Sphinkie/Arditime/README.md

# Arditime

Arduino steampunk timer

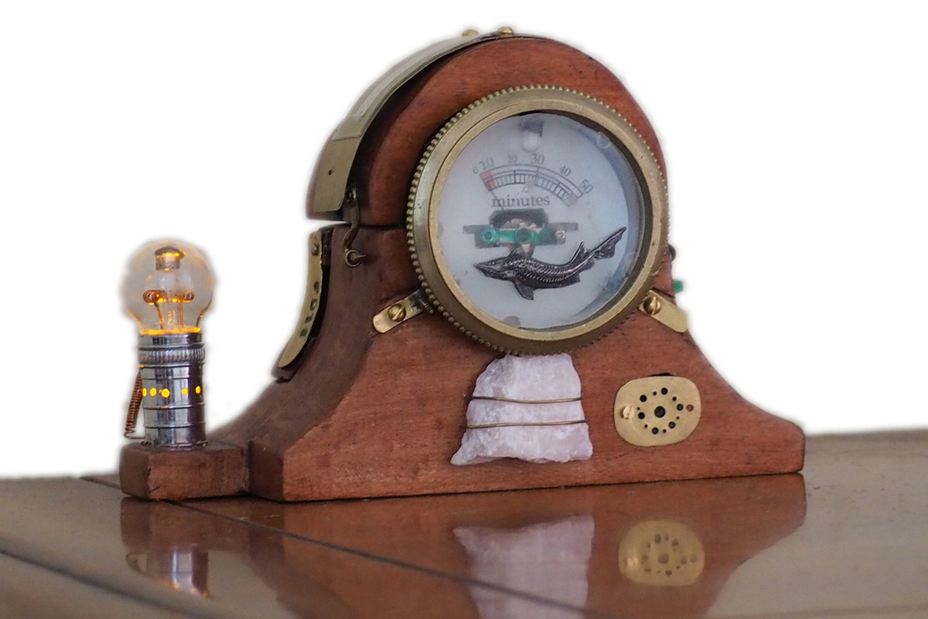
[picture p1: docs/images/arditime-1.JPG]
Arditime


## A tactile timer

Pass your finger along the top of the clock: the Arditime machine will wake up and indicate the choosen duration of the timeout on the dial (in minutes).  

Then, two minutes before the timer expires, the stone will start to glow red.  And when the timer expires, you will hear the sound of a gong.  

(During all the duration of the timer, the old amber lamp will light slowly.)  

## Credits

* Arduino **speaker_pcm** library by Michael Smith, for playing 8-bit PCM audio on pin 11 using pulse-width modulation (PWM).
* Windows **[WaveToCode](https://www.softpedia.com/get/Multimedia/Audio/Other-AUDIO-Tools/WAVToCode.shtml)** application by JCS, which convert WAV audio files into C code for inclusion in embedded systems projects. 
* **[KiCAD](http://kicad-pcb.org/)** for electronic design 
* **[VeeCAD](https://veecad.com/)** for PCB design on veroboards
