Sphinkie/Arditime/sounds/WAV/readme.md

## Wav files converted with Audacity.

to convert:
- **Mono**
- **8 kHz** : Status bar   -> "Projet à 8000Hz"
- **8-bits**: Export audio -> other uncompressed format  -> options: "WAV (Microsoft)" & "Unsigned 8 bit PCM"
