Sphinkie/Arditime/docs/pages/electronique.md

## Réalisation électronique

### Schéma

Le schéma (relativement simple) a été fait avec **[Fritzing](https://fritzing.org/)** Fritzing.

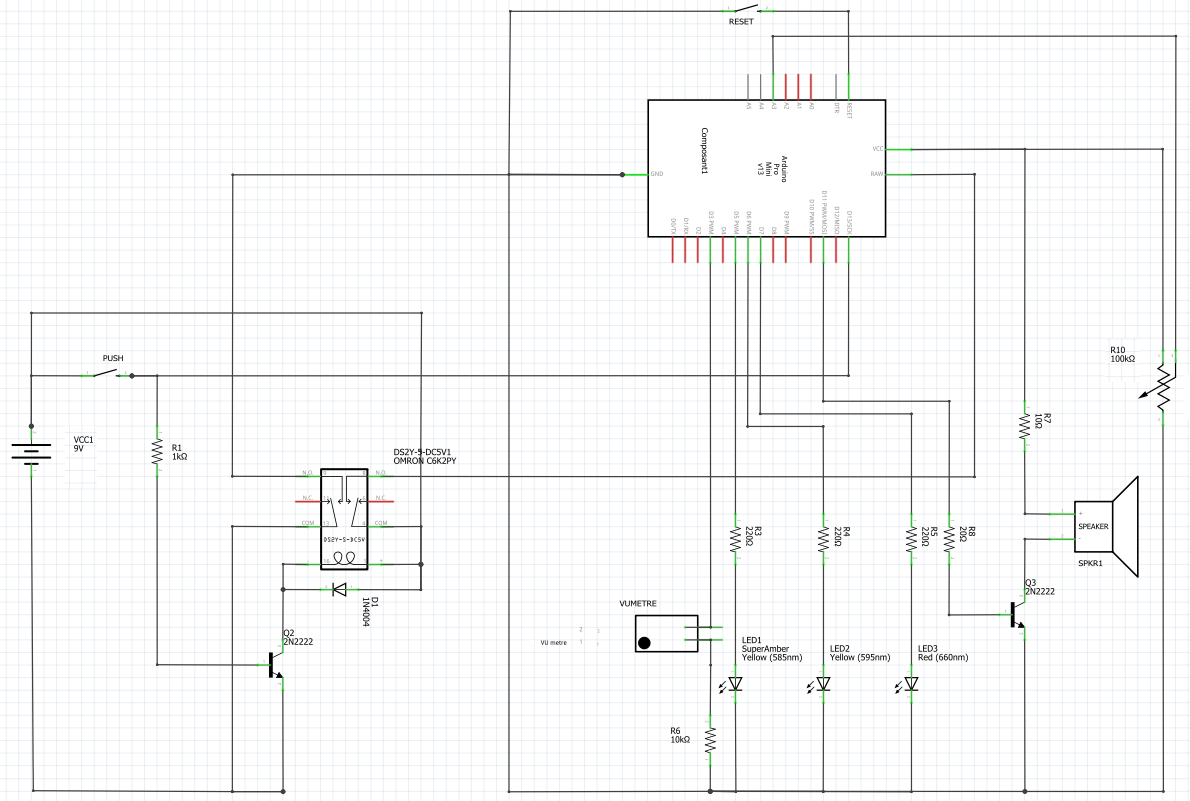
[picture p7: docs/images/schematic.png]
schematic


------

## Printed Circuit Board (PCB) – Circuit imprimé

Pour la préparation des PCB sur des cartes VERIBOARD, le logiciel gratuit **[VeeCAD](https://veecad.com/)** VeeCAD a été utilisé.

### Carte principale avec Arduino Mini Pro 5v

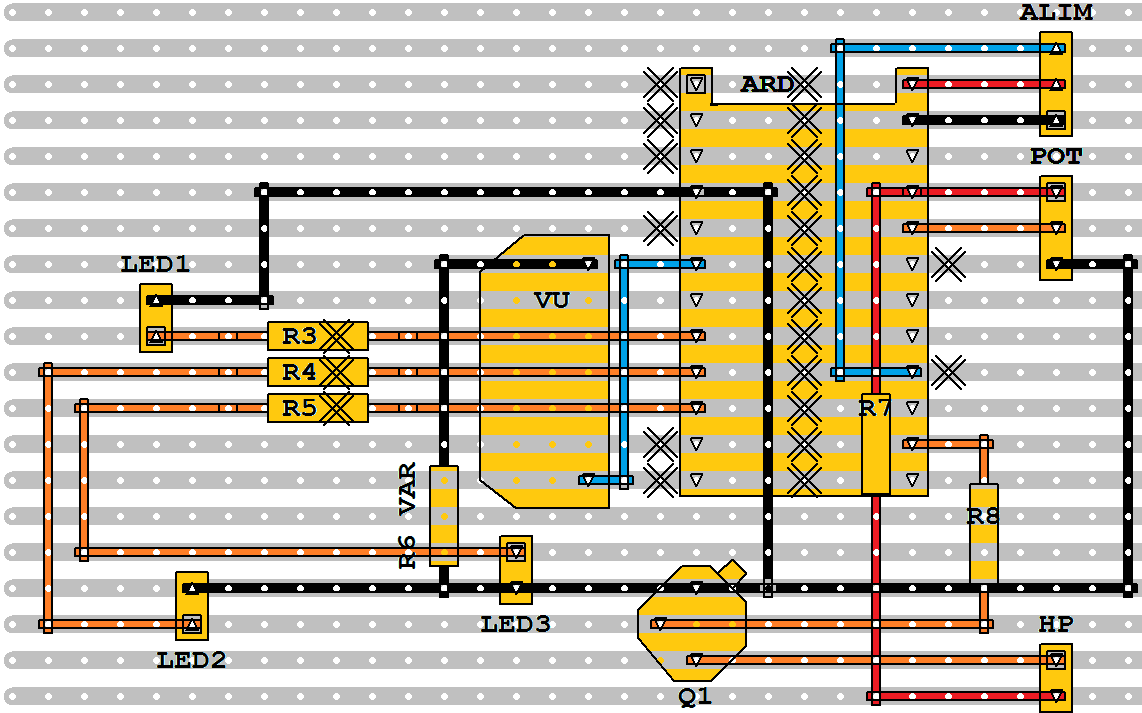
[picture p8: docs/images/PCB-1.png]
main board


### Carte Auto-OFF

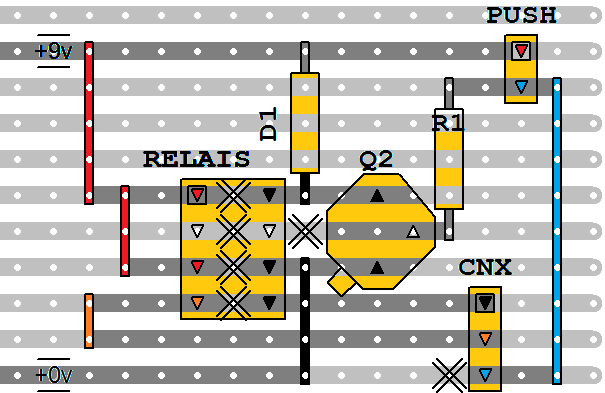
[picture p9: docs/images/PCB-2.png]
auto-off board


------

**[► Home](../index.md)**
