Sphinkie/Arditime/docs/index.md

# Arditime machine

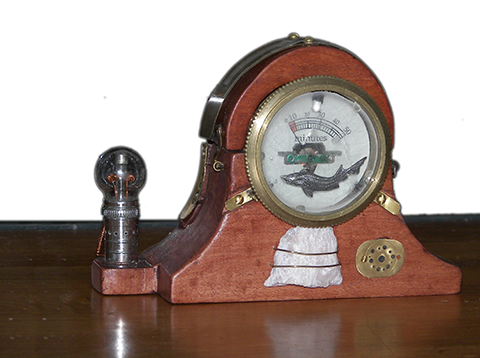
[picture p11: docs/images/1.png]


Arditime est un minuteur longue durée (2 à 60 minutes) qui émet une lumière rouge et un son de gong, à la fin de la minuterie.

Votre enfant n'a droit qu'à 20 minutes de jeu vidéo ?

Passez le doigt sur le contacteur tactile situé sur le dessus, et faites-le glisser jusqu'à ce que l'aiguille indique 20 minutes.
Le minuteur démarre et le gong retentira une fois le délai expiré ! 

-----

## Table des matières

1. Arditime machine
2. [Principaux modules](pages/modules)
3. [Software](pages/software)
4. [Fabrication](pages/fabrication)
5. [Réalisation électronique](pages/electronique)
