Sphinkie/Arditime/docs/images/arditime-2.JPG

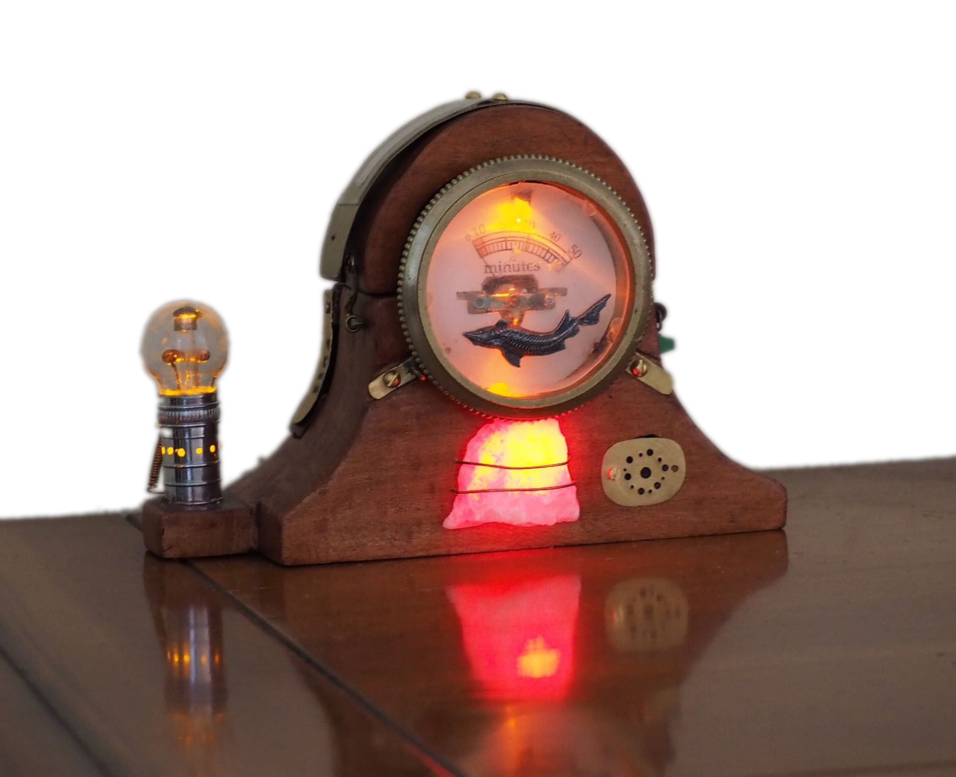
docs/images/arditime-2.JPG
