Sphinkie/Arditime/docs/images/cadran-01.png

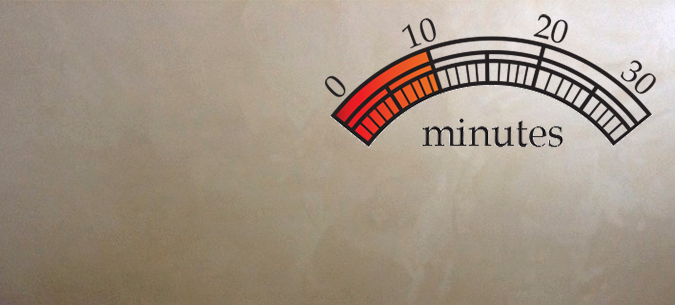
docs/images/cadran-01.png
