Sphinkie/Arditime/docs/images/stone.png

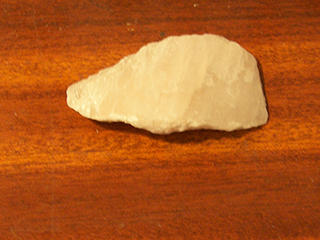
docs/images/stone.png
