Sphinkie/Arditime/schematics/Design/cadran-02.png

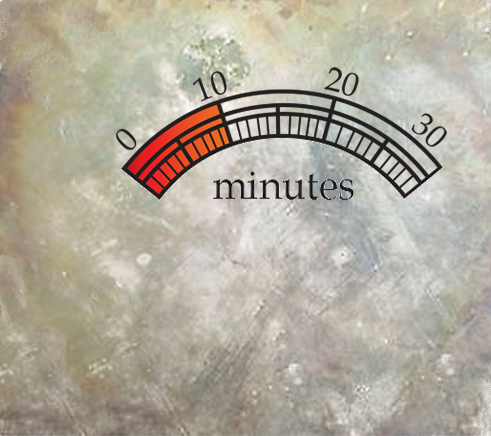
schematics/Design/cadran-02.png
