Sphinkie/Arditime/schematics/Design/Cadran.png

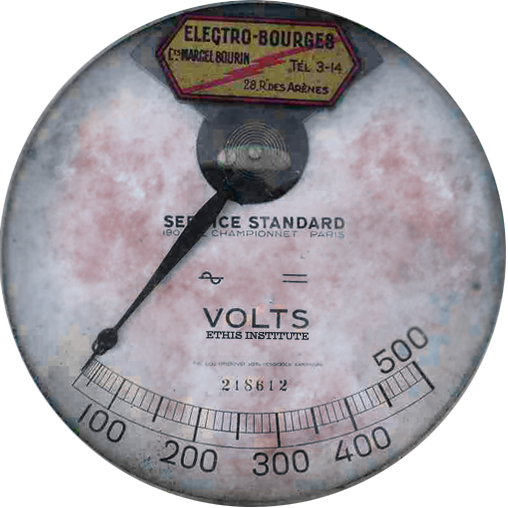
schematics/Design/Cadran.png
