Sphinkie/Arditime/schematics/kiCad/ArdiTime_schematic.png

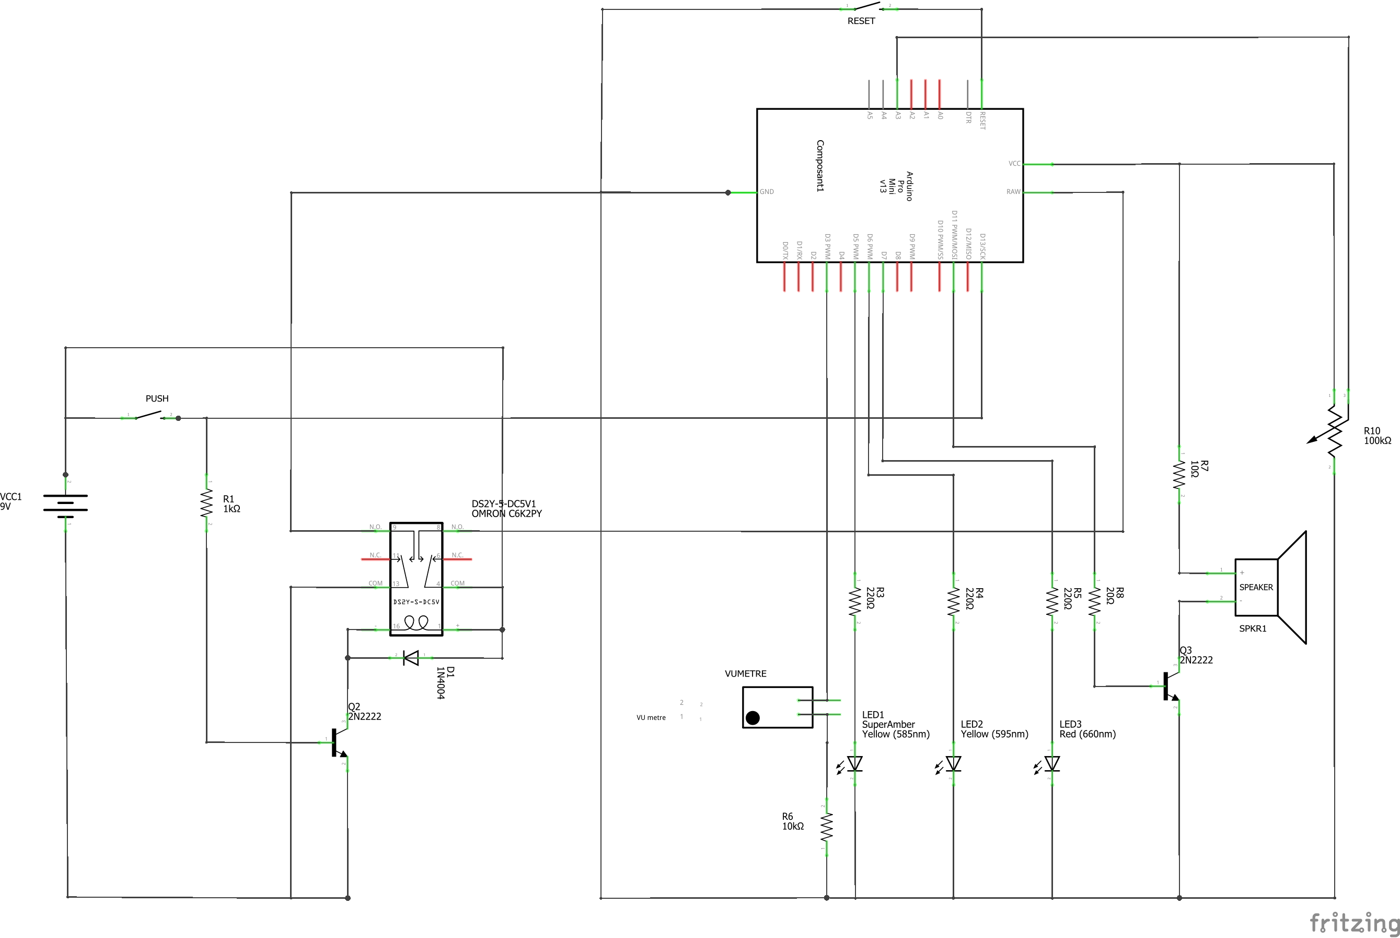
schematics/kiCad/ArdiTime_schematic.png
