Sphinkie/Arditime/schematics/veecad/VeeCAD PCB - BW.png

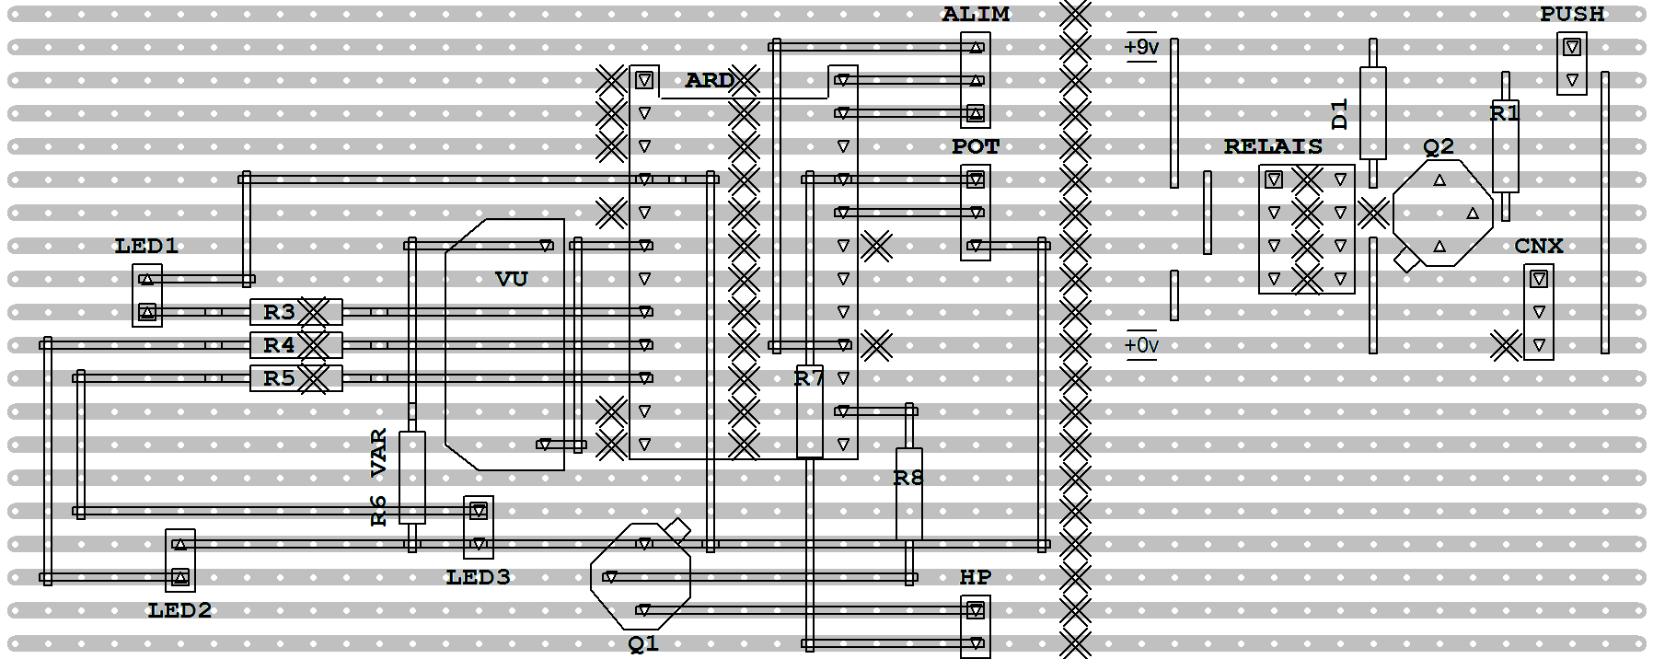
schematics/veecad/VeeCAD PCB - BW.png
