Sphinkie/Arditime/schematics/veecad/VeeCAD PCB.png

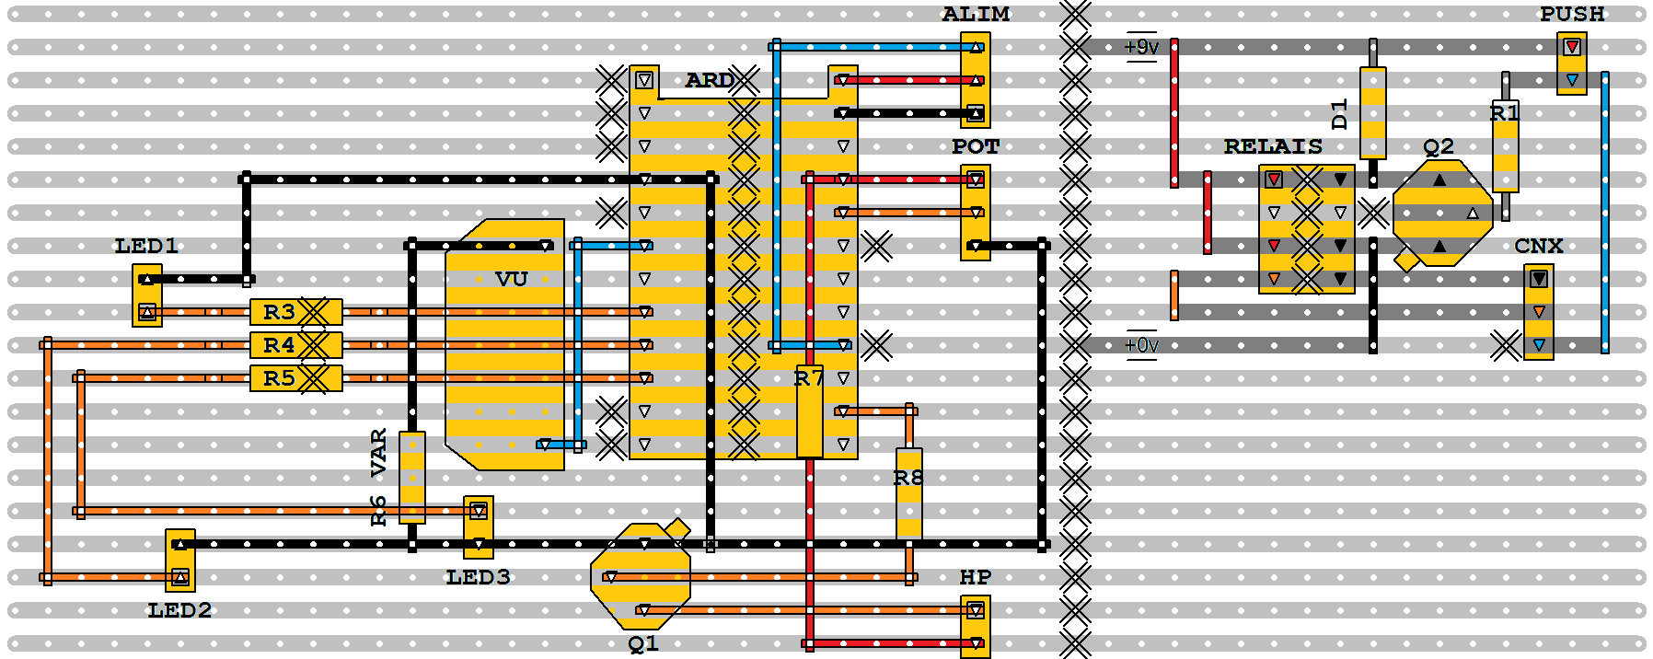
schematics/veecad/VeeCAD PCB.png
