Sphinkie/Arditime/docs/pages/fabrication.md

## Fabrication

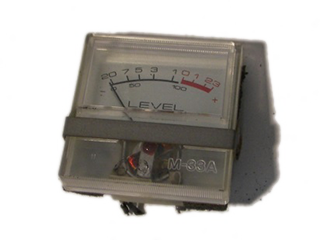
[picture p21: docs/images/vumetre.png]
vumetre

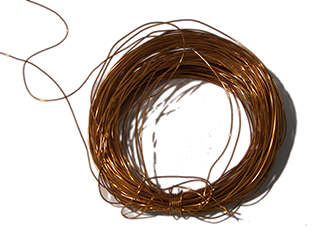
[picture p22: docs/images/wire.png]
copper wire

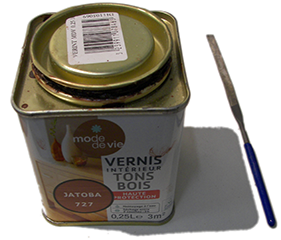
[picture p23: docs/images/vernis.png]
vernis

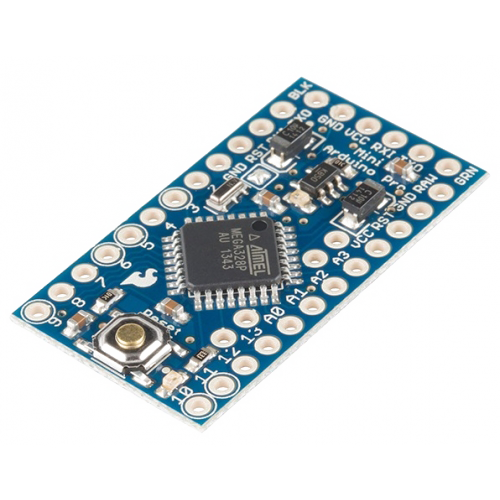
[picture p24: docs/images/arduino-mini.png]
arduino


### Boitier en bois

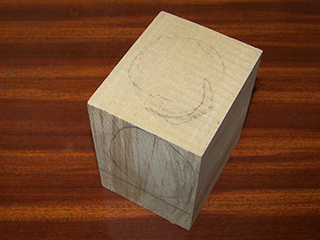
[picture p25: docs/images/wood.png]
wood

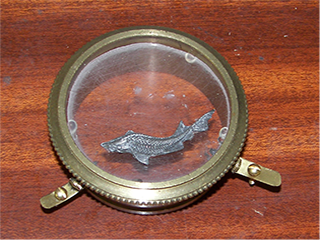
[picture p26: docs/images/dial.png]
dial


La forme particulière a été obtenue en sculptant des blocs de hêtre (quelques euros chez [Boesner](https://www.boesner.fr/)), et en utilisant des objets de récupération.

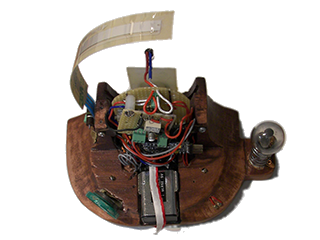
[picture p27: docs/images/boitier-2.png]
boitier
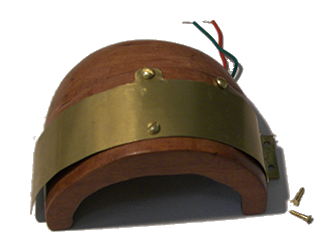
[picture p28: docs/images/boitier-3.png]
boitier


### Croquis préparatoires

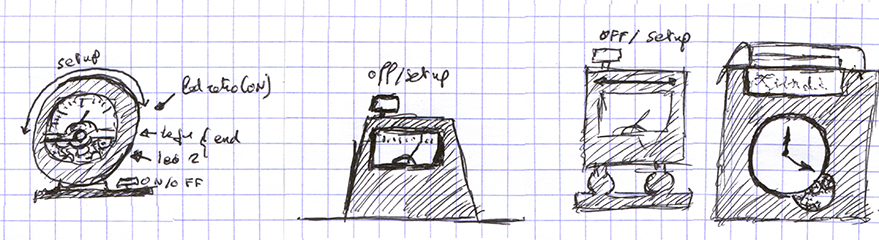
[picture p29: docs/images/sketches.png]
sketches


------

**[► Home](../index.md)**
