Sphinkie/Arditime/sources/Gonghi.h

/**********************************************************************
* Written by WAVToCode
* Date:			  	    Mon Feb 27 2017 10:45:08 PM
* FileName:			    Gonghi.h
* Interleaved:	    Yes
* Signed:			      No
* No. of channels:	1
* No. of samples:	  20311
* Bits/Sample:		  8
**********************************************************************/

#define NUM_ELEMENTS 20311

const unsigned char data[NUM_ELEMENTS] PROGMEM = {
128, 128, 127, 127, 127, 127, 127, 128, // 0-7
128, 128, 128, 128, 127, 127, 127, 127, // 8-15
128, 128, 128, 127, 127, 127, 127, 127, // 16-23
128, 128, 128, 127, 127, 127, 127, 128, // 24-31
128, 129, 129, 129, 129, 128, 129, 129, // 32-39
129, 129, 129, 129, 129, 128, 128, 128, // 40-47
128, 128, 128, 128, 128, 128, 128, 129, // 48-55
129, 129, 129, 128, 128, 127, 128, 128, // 56-63
128, 128, 129, 128, 128, 127, 127, 126, // 64-71
125, 126, 128, 131, 132, 130, 125, 120, // 72-79
118, 123, 130, 135, 137, 135, 132, 128, // 80-87
125, 123, 121, 120, 118, 119, 125, 134, // 88-95
137, 131, 119, 108, 105, 120, 140, 156, // 96-103
160, 146, 123, 104,  91,  88, 100, 120, // 104-111
139, 152, 158, 155, 144, 129, 118, 116, // 112-119
119, 119, 110,  99,  93, 104, 130, 154, // 120-127
158, 140, 113,  93,  93, 119, 155, 184, // 128-135
197, 183, 147, 110,  82,  68,  70,  91, // 136-143
125, 157, 176, 172, 151, 131, 123, 122, // 144-151
113,  93,  71,  56,  65, 108, 164, 203, // 152-159
205, 170, 124,  95,  99, 129, 161, 183, // 160-167
191, 176, 140,  97,  62,  40,  43,  77, // 168-175
122, 154, 164, 160, 156, 159, 161, 149, // 176-183
124,  94,  70,  64,  87, 133, 175, 199, // 184-191
196, 171, 138, 108,  89,  90, 113, 146, // 192-199
174, 172, 138,  96,  66,  52,  61,  90, // 200-207
125, 150, 164, 176, 189, 202, 200, 169, // 208-215
120,  77,  49,  45,  68, 106, 146, 179, // 216-223
199, 192, 155, 109,  72,  63,  89, 132, // 224-231
162, 162, 136, 107,  88,  89, 109, 135, // 232-239
152, 159, 164, 174, 187, 194, 183, 151, // 240-247
110,  76,  52,  37,  36,  63, 114, 165, // 248-255
196, 190, 153, 116,  94,  99, 127, 157, // 256-263
168, 153, 126, 108, 108, 119, 128, 129, // 264-271
127, 131, 141, 150, 157, 160, 158, 142, // 272-279
114,  84,  61,  44,  41,  71, 127, 180, // 280-287
212, 206, 165, 125, 106, 113, 132, 143, // 288-295
143, 134, 124, 117, 111, 106, 107, 113, // 296-303
122, 125, 124, 127, 140, 162, 184, 189, // 304-311
159, 114,  77,  50,  42,  74, 130, 175, // 312-319
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
