Sphinkie/Arditime/(commit log)

2018-01-24 external libraries used by the project
    Arduino PCM library
    Arduino SimpleTimer library
2018-01-24 Electronic schematics
    Schematic with kiCad
    PCB layout with VeeCad
2018-01-24 KiCad files
    [ArdiTime.kicad_pcb, ArdiTime.sch]
